Tiranicle/Mazda-MX-5-NA-Speaker-Panel-Reverse-Engineering-and-Modification/DoorSpeakerPanel_scanexport_simplified.stl

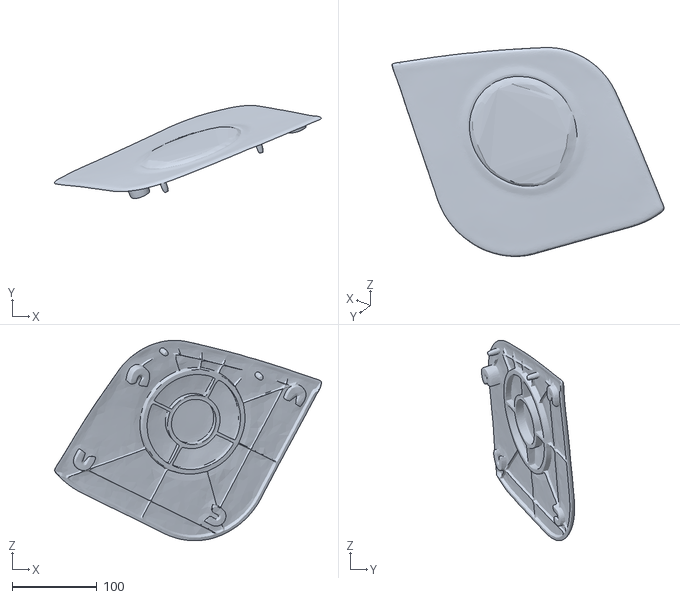
[picture p15: CAD file, 2026-10-27]
DoorSpeakerPanel_scanexport_simplified.stl
314.3 x 109.7 x 235.8
