Tiranicle/Mazda-MX-5-NA-Speaker-Panel-Reverse-Engineering-and-Modification/(list of files, cad)

Other CAD files:
DoorSpeakerPanel_scanexport_refined.stl
